rzedka/TRN-Generator/eagle/NoiseGen_1.pdf

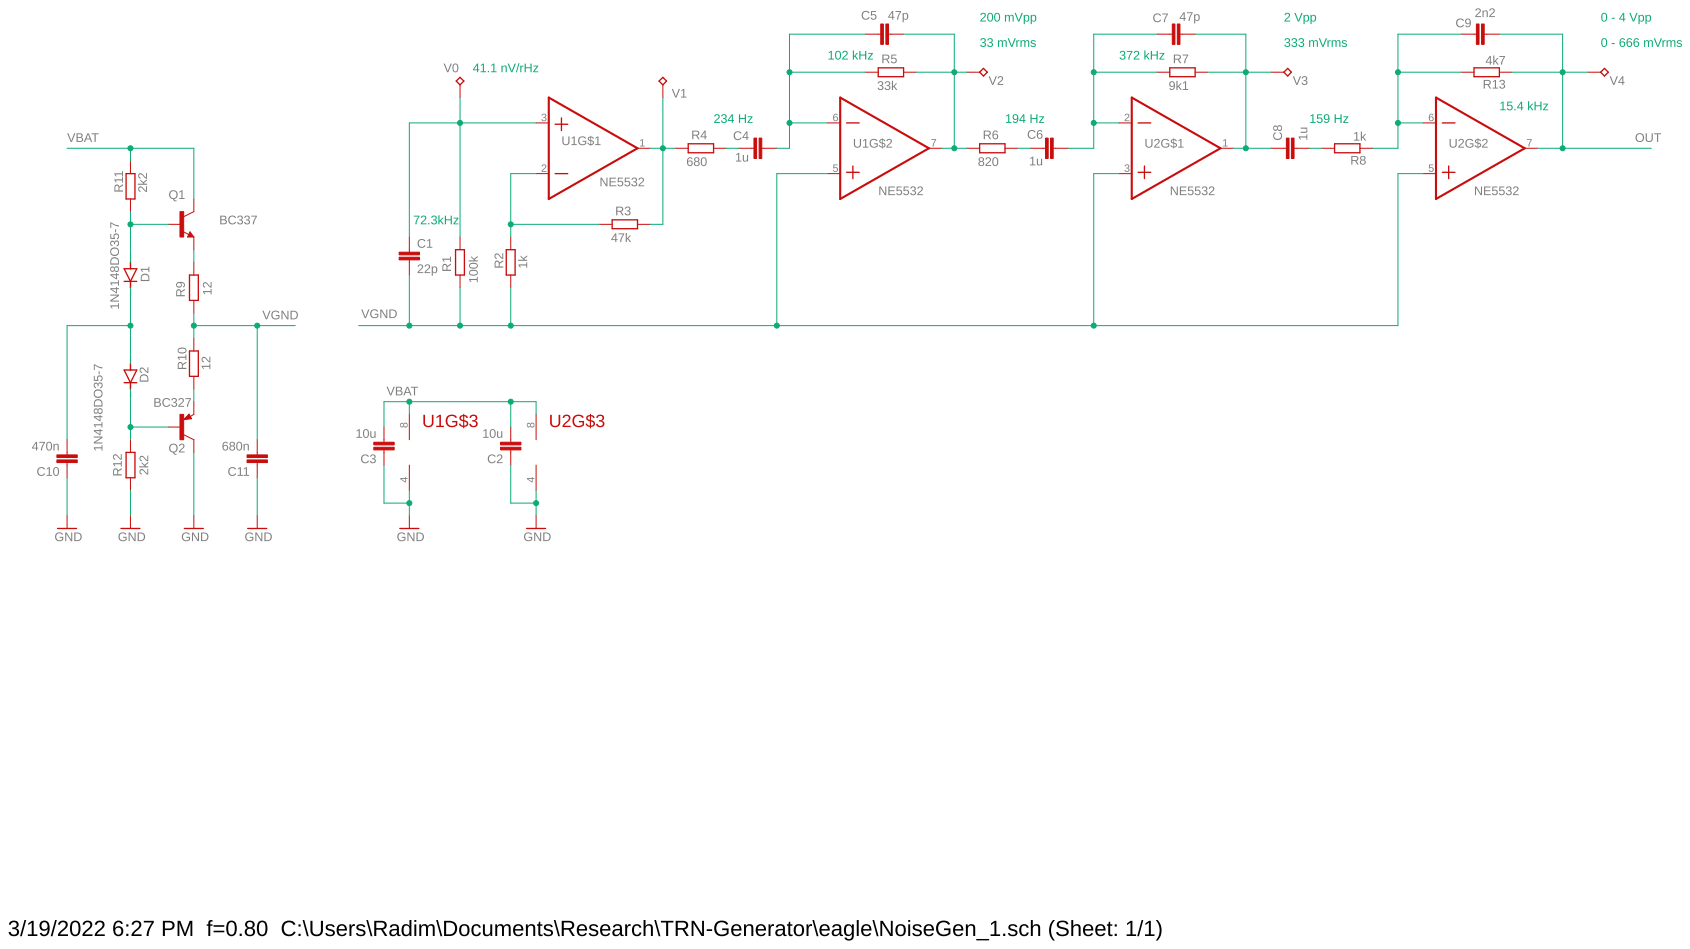
[picture p8: page 1]
