rzedka/TRN-Generator/eagle/NoiseGen_1.sch

## EAGLE design eagle/NoiseGen_1.sch (2022-03-19)

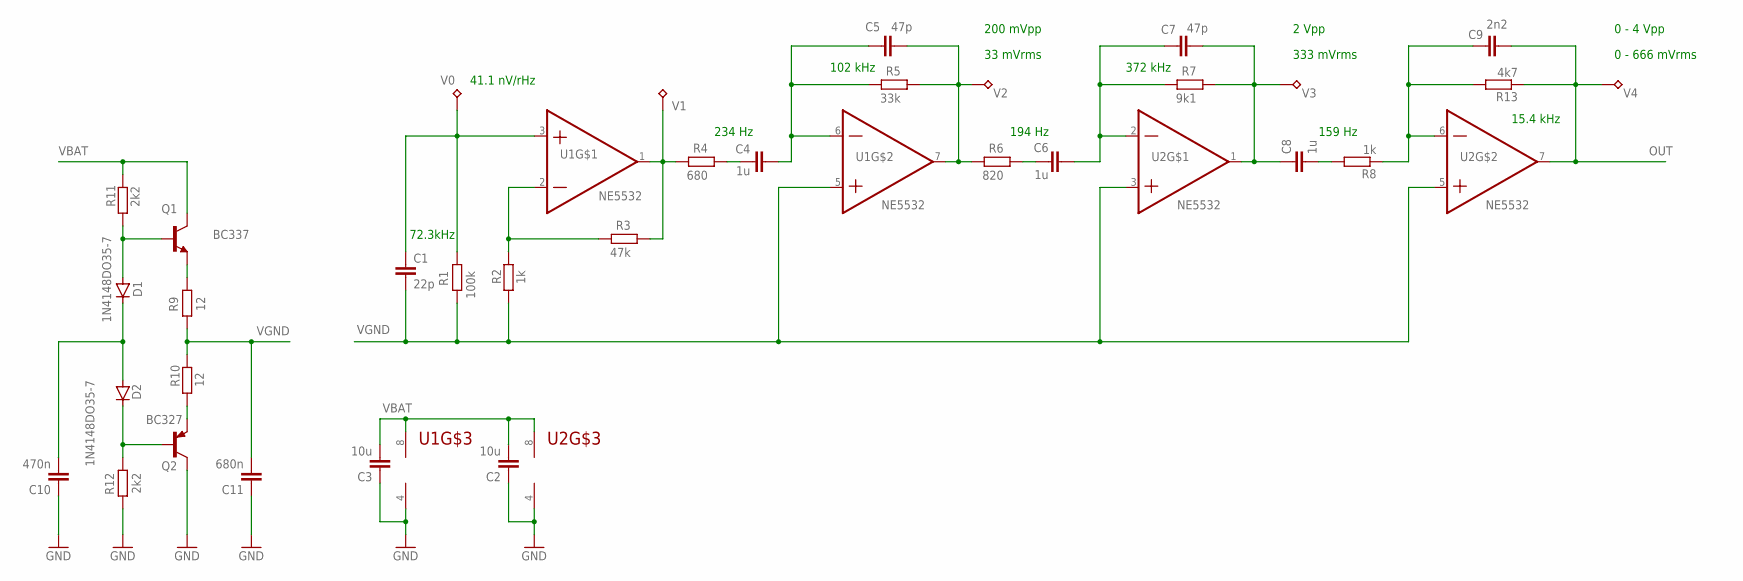
[picture p9: schematic NoiseGen_1.sch]

Parts:
C1: 22p; C0805
C2, C3: 10u; C0805
C4, C6, C8: 1u; C0805
C5, C7: 47p; C0805
C9: 2n2; C0805
C10: 470n; C0805
C11: 680n; C0805
D1, D2: 1N4148DO35-7; DO35-7
Q1: BC337; TO92
Q2: BC327; TO92
R1: 100k; R0805
R2, R8: 1k; R0805
R3: 47k; R0805
R4: 680; R0805
R5: 33k; R0805
R6: 820; R0805
R7: 9k1; R0805
R9, R10: 12; R0805
R11, R12: 2k2; R0805
R13: 4k7; R0805
U1, U2: NE5532; DIL-8
V0, V1, V2, V3, V4: TESTPAD

Connections:
GND: C2.1, C3.1, C10.1, C11.1, Q2.3 (C), R12.2, U1.4 (VN), U2.4 (VN)
unnamed: C10.2, D1.C, D2.A
unnamed: C1.1, R1.2, U1.3 (+IN), V0.P$1
unnamed: R2.2, R3.2, U1.2 (-IN)
unnamed: C4.1, R4.1
unnamed: R3.1, R4.2, U1.1 (OUT), V1.P$1
unnamed: C5.2, R5.1, R6.2, U1.7 (OUT), V2.P$1
unnamed: C4.2, C5.1, R5.2, U1.6 (-IN)
unnamed: C6.2, C7.1, R7.2, U2.2 (-IN)
unnamed: C6.1, R6.1
unnamed: C7.2, C8.1, R7.1, U2.1 (OUT), V3.P$1
unnamed: C8.2, R8.2
unnamed: C9.1, R8.1, R13.2, U2.6 (-IN)
unnamed: D1.A, Q1.2 (B), R11.2
unnamed: D2.C, Q2.2 (B), R12.1
unnamed: Q2.1 (E), R10.2
unnamed: Q1.1 (E), R9.2
OUT: C9.2, R13.1, U2.7 (OUT), V4.P$1
VBAT: C2.2, C3.2, Q1.3 (C), R11.1, U1.8 (VP), U2.8 (VP)
VGND: C1.2, C11.2, R1.1, R2.1, R9.1, R10.1, U1.5 (+IN), U2.3 (+IN), U2.5 (+IN)

Notes on the sheet:
41.1 nV/rHz
72.3kHz
234 Hz
102 kHz
194 Hz
372 kHz
159 Hz
33 mVrms
333 mVrms
2 Vpp
200 mVpp
0 - 4 Vpp
0 - 666 mVrms
15.4 kHz
