rzedka/TRN-Generator/(commit log)

2022-03-07 MATLAB and Eagle files
    [NoiseGen_1.sch]
2022-03-19 updating schematic
    [NoiseGen_1.sch]
